linamehrle/Surveillance_Camera/README.md

# Surveillance Camera

This repository contains code and the project report for the lecture Computer Architecture at university of Basel, HS24.
The goal of the project was to build a surveillance camera like device that is able to sense movement, turn towards it and then take a picture and store it on an SD-card.
