linamehrle/Surveillance_Camera/report/titlepage.tex

\begin{titlepage}
    \begin{center}
        \vspace*{1cm}
            
        \Huge
        \textbf{Surveillance Camera\\ - \\Project Report}
            
        \vspace{0.8cm}
        \LARGE
            
        \textbf{Heinrich Ahrend, Simon Hammer, Jennifer Jäger, Lina Mehrle}

        \vfill
            
        Computer Architecture Project\\
        Fall Semester 2024

        \vspace{0.8cm}
        \vspace{0.8cm}
            
        \Large
        Department of Mathematics an Computer Science\\
        University of Basel\\
        \today
            
    \end{center}
\end{titlepage}
