linamehrle/Surveillance_Camera/(commit log)

2025-01-21 Add code for ESP32-Cam
2025-01-21 Add code for Arduino
2025-01-21 Let motor stand still if both sensors detect signal
